thwill1000/pico-game-vga/software/README.md

# Contents

**flash8-menu.bas**
 * This is a very simple menu for the files stored in flash memory. The best bit
is the coloured logo though. :) Install it in flash slot 8 and use
OPTION AUTORUN 8 to get a cool 1970's feel. lol

**PicoGAME-test-proto.bas**
 * This is a test program to put the PicoGAME prototype through its paces a
bit. Well, it might show up the occasional mis-soldered joint. :)

**PicoGAME-test-14.bas**
 * This is a test program to put the PicoGAME v14(a) through its paces a bit.
Well, it might show up the occasional mis-soldered joint. :)
