thwill1000/pico-game-vga/hardware/v14/14 Circuit diagram.pdf

# 3V3 VREF GP28 AGND GND GND GP27 GP26 RUN

# GP22 GP21 GP20 GP19 GP18 GP17 GP16

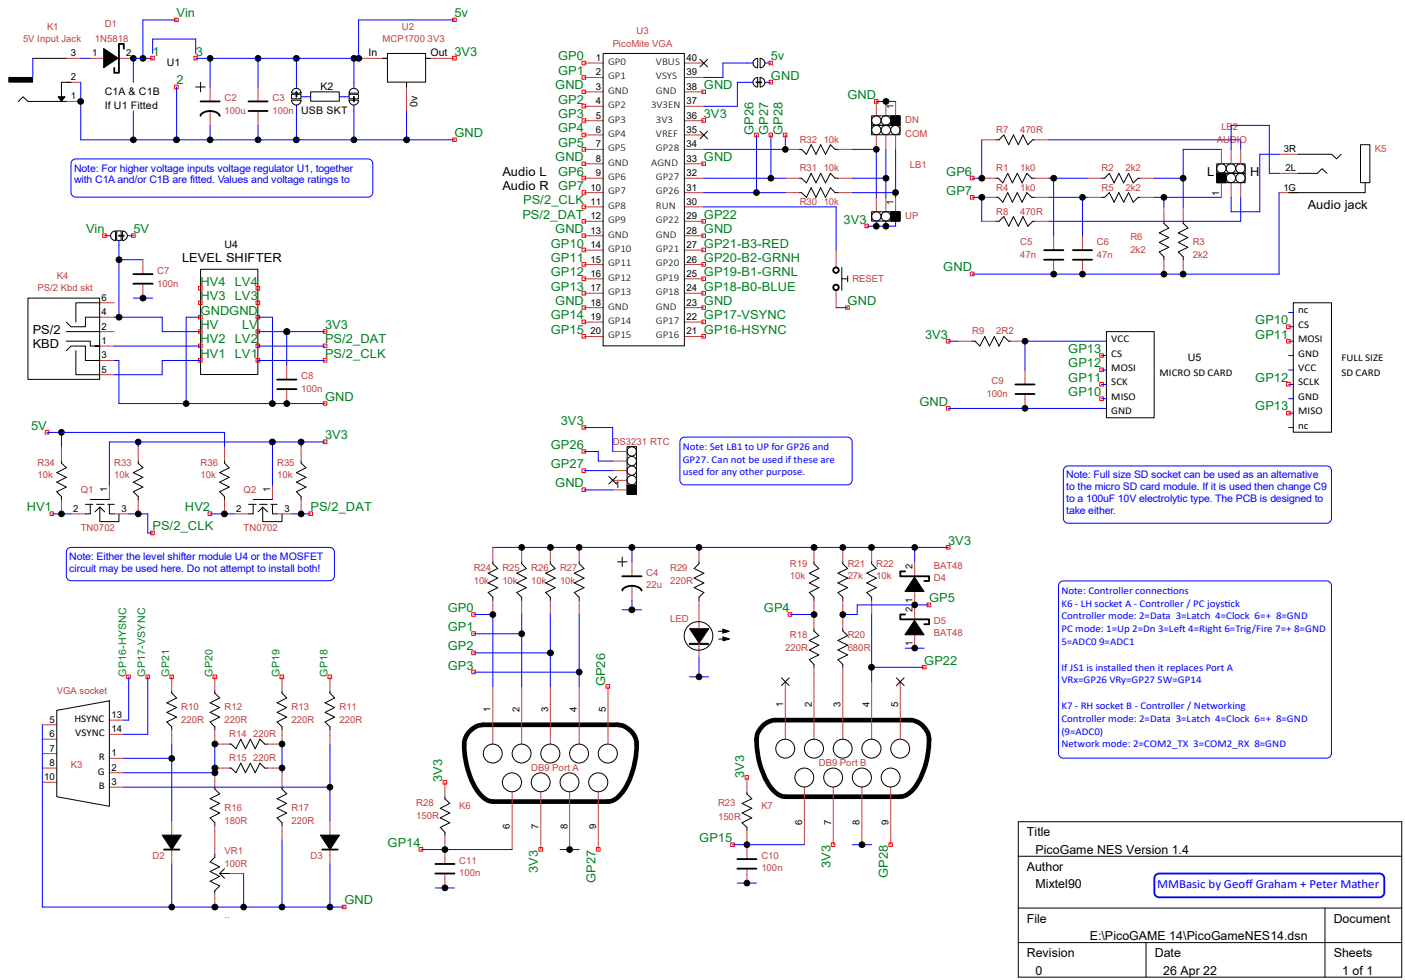
[picture p5: page 1]

Note: For higher voltage inputs voltage regulator U1, together
with C1A and/or C1B are fitted. Values and voltage ratings to

GND GP¹⁶⁻HYSNC GP¹⁷⁻VSYNC

Note: Full size SD socket can be used as an alternative
to the micro SD card module. If it is used then change C9
to a 100uF 10V electrolytic type. The PCB is designed to

Note: Either the level shifter module U4 or the MOSFET
circuit may be used here. Do not attempt to install both!

Note: Controller connecons K6 - LH socket A - Controller / PC joysck Controller mode: 2=Data 3=Latch 4=Clock 6=+ 8=GND

PC mode: 1=Up 2=Dn 3=Le 4=Right 6=Trig/Fire 7=+ 8=GND
5=ADC0 9=ADC1

If JS1 is installed then it replaces Port A
VRx=GP26 VRy=GP27 SW=GP14

K7 - RH socket B - Controller / Networking Controller mode: 2=Data 3=Latch 4=Clock 6=+ 8=GND (9=ADC0)

MMBasic by Geoff Graham + Peter Mather

File E:\PicoGAME 14\PicoGameNES14.dsn | Document

Revision 0 | Date 26 Apr 22 | Sheets 1 of 1
