thwill1000/pico-game-vga/(list of files, drawings)

Other design files:
hardware/v11/PicoGameNES00.dsn
hardware/v11/PicoGameNES11.lay6
hardware/v14/PicoGameNES14.dsn
hardware/v14/PicoGameNES14.lay6
hardware/v14a/PicoGameNES14 A.lay6
hardware/v14a/PicoGameNES14A.dsn
